gloworm-vision/gloworm/case/README.md

# Case

Onshape: https://cad.onshape.com/documents/2d77462d72aa178cf6106d9a/w/a3a16c3af941759808ea00c9/e/243b0106afc4af037aefc7d1

Print at 20% grid infill with PETG.
