gloworm-vision/gloworm/case/GlowormFrontCase.stl

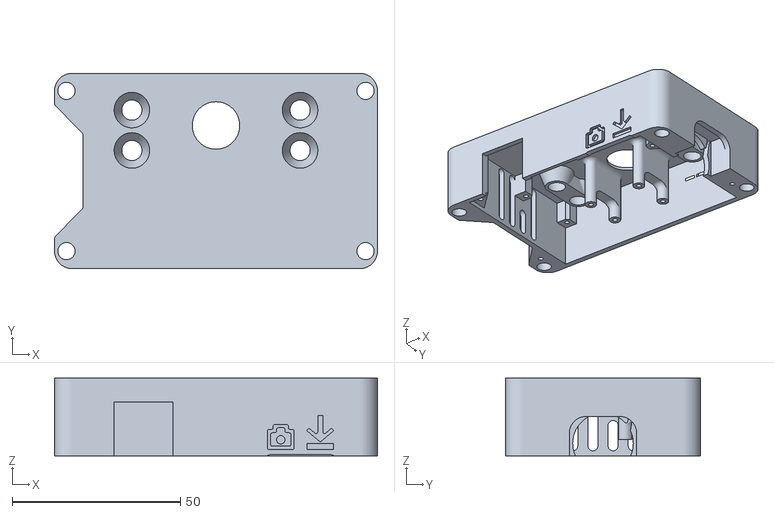
[picture p1: CAD file, 2020-08-04]
case/GlowormFrontCase.stl
96.0 x 58.0 x 23.1
