gloworm-vision/gloworm/case/GlowormCase.step

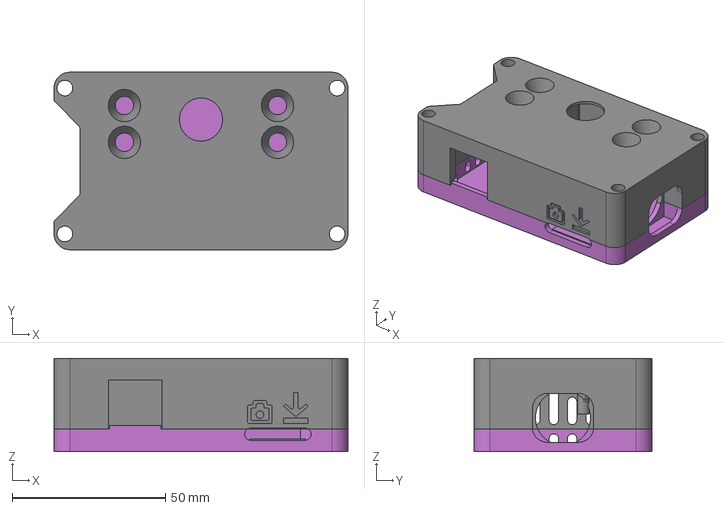
[picture p2: CAD file, 2020-08-04]
case/GlowormCase.step
96.0 x 58.0 x 30.4 mm
