gloworm-vision/gloworm/case/GlowormRearCase.stl

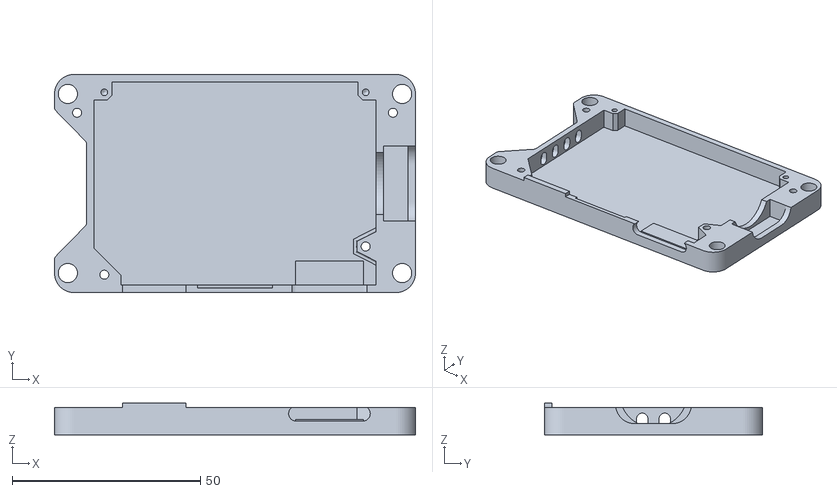
[picture p3: CAD file, 2020-08-04]
case/GlowormRearCase.stl
96.0 x 58.0 x 8.43
