gloworm-vision/gloworm/(commit log)

2020-07-01 Initial public release
    [gloworm.kicad_pcb, gloworm.sch, ledboard.kicad_pcb, ledboard.sch]
2020-07-10 Initial public release v0.4.0
    [gloworm.kicad_pcb, gloworm.sch, ledboard.kicad_pcb, ledboard.sch]
2020-07-10 Move +12V bulk cap to make way for camera cable
    [gloworm.kicad_pcb]
2020-07-11 Add 1mm/2mm fiducials to LED board (part of #8)
    [ledboard.kicad_pcb]
2020-07-11 Switch to 0805 sense res on ledboard (closes #7)
    [ledboard.kicad_pcb, ledboard.sch]
2020-07-11 Add simple ledboard status LED models (closes #9)
    [ledboard.kicad_pcb]
2020-07-11 Remove mainboard camera cable cutout (closes #10)
    [gloworm.kicad_pcb]
2020-07-11 Add 1mm/2mm fiducials to mainboard (closes #8)
    [gloworm.kicad_pcb]
2020-07-11 Add 0-ohm jumpers to USB data lines (closes #4)
    [gloworm.kicad_pcb, gloworm.sch]
2020-07-11 Swap 10uF ledboard bulk caps for 22 (closes #6)
    [gloworm.kicad_pcb, gloworm.sch]
2020-07-11 Switch to TLV62569 for 1.8/3.3v (closes #1)
    [gloworm.kicad_pcb, gloworm.sch]
2020-07-11 Cleanup GND vias
    [gloworm.kicad_pcb, gloworm.sch]
2020-07-11 Add 22uF bulk cap to 3.3V/1.8V vreg vin (closes #2)
    [gloworm.kicad_pcb, gloworm.sch]
2020-07-11 Replace 6.3V 22uF caps on >6.3V rails with 25V 10u
    * Accidentally put some 6.3V rated 22uF caps on 12v rails like the LED
    board and 12V vreg input. This replaces those with 25V 10uF caps.
    [gloworm.kicad_pcb, gloworm.sch]
2020-07-11 Add 10uF/side to ledboard, add "generic ok" bom column
    [ledboard.kicad_pcb, ledboard.sch]
2020-07-11 Fix weird accidental solid pad connection on C15
    [gloworm.kicad_pcb]
2020-07-12 RoundRect pads, add gloworm logo
    [gloworm.kicad_pcb, gloworm.sch]
2020-07-12 Cleanup U5/U6 labels
    [gloworm.kicad_pcb]
2020-07-12 Add DNP 10uF cap for 1v8reg
    [gloworm.kicad_pcb, gloworm.sch]
2020-07-13 Cleanup VUSB rail routing, add back unlocked fiducial
    [gloworm.kicad_pcb, ledboard.kicad_pcb]
2020-07-13 Cleanup (mostly adding GND vias)
    [gloworm.kicad_pcb]
2020-07-13 More cleanup
    [gloworm.kicad_pcb, gloworm.sch]
2020-07-13 Increment version to v0.4.1
    [gloworm.kicad_pcb]
2020-07-13 5v buck regulator improvements
    [gloworm.kicad_pcb, gloworm.sch, ledboard.kicad_pcb, ledboard.sch]
2020-07-14 Add AC decoupling caps for USB,CSI, cleanup
    [gloworm.kicad_pcb, gloworm.sch]
2020-07-15 Fix AGND issue and cleanup
    * Resistor divider and SS cap should've been connected to AGND
    * Remove USB series resistors since they were cluttering everything up
    and I've determined they aren't needed
    * General cleanup
    [gloworm.kicad_pcb, gloworm.sch]
2020-07-15 Set vregs to Solid again
    [gloworm.kicad_pcb]
2020-07-15 FSUSB42MUX cleanup
    [gloworm.kicad_pcb]
2020-07-17 Add fan control mosfet (gpio 45)
    [gloworm.kicad_pcb, gloworm.sch]
2020-07-22 Fix fan connector polarity
    [gloworm.kicad_pcb, gloworm.sch]
2020-07-28 LED board improvements
    * Swap 0.33 SET resistor for 0.3, thermal testing indicates we can run
    at the full test current of 350mA.
    * Move bulk caps a little
    * Fix old version silk
    [ledboard.kicad_pcb, ledboard.sch]
2020-07-29 Move vias from under HRO connectors
    [gloworm.kicad_pcb]
2020-07-31 Increase Hro paste-in-hole size
    [gloworm.kicad_pcb]
2020-07-31 Fix camera port CC resistors
    [gloworm.kicad_pcb, gloworm.sch]
2020-08-04 Add case files
    Onshape V15
    Includes STEPs of full model with case as well as case only.
    Includes millimeter STLs of front and back case pieces.
    [GlowormCase.step, GlowormFrontCase.stl, GlowormRearCase.stl]
2020-08-04 Add case gcode
    [gloworm.kicad_pcb, ledboard.kicad_pcb]
2020-08-16 Add fan flyback, keepout mounting holes
    [gloworm.kicad_pcb, gloworm.sch]
2020-08-16 Move case onshape link to case README
2020-09-06 Better USB C paste layout
    [gloworm.kicad_pcb]
2020-09-14 Cleanup mainboard
    [gloworm.kicad_pcb]
