gloworm-vision/gloworm/(notices)

Notices in the files:
pcb/mainboard/gloworm.kicad_pcb:
Copyright Franklin Harding 2020
Licensed under CERN-OHL-P v2
© Franklin Harding 2020
